johannes85/numitron-watch/README.md

Numitron Geekwatch
==============

See: http://www.domestichacks.info/projekte/numitron-geekwatch-armbanduhr/
