johannes85/numitron-watch/schematics/watch_main_schematics.png

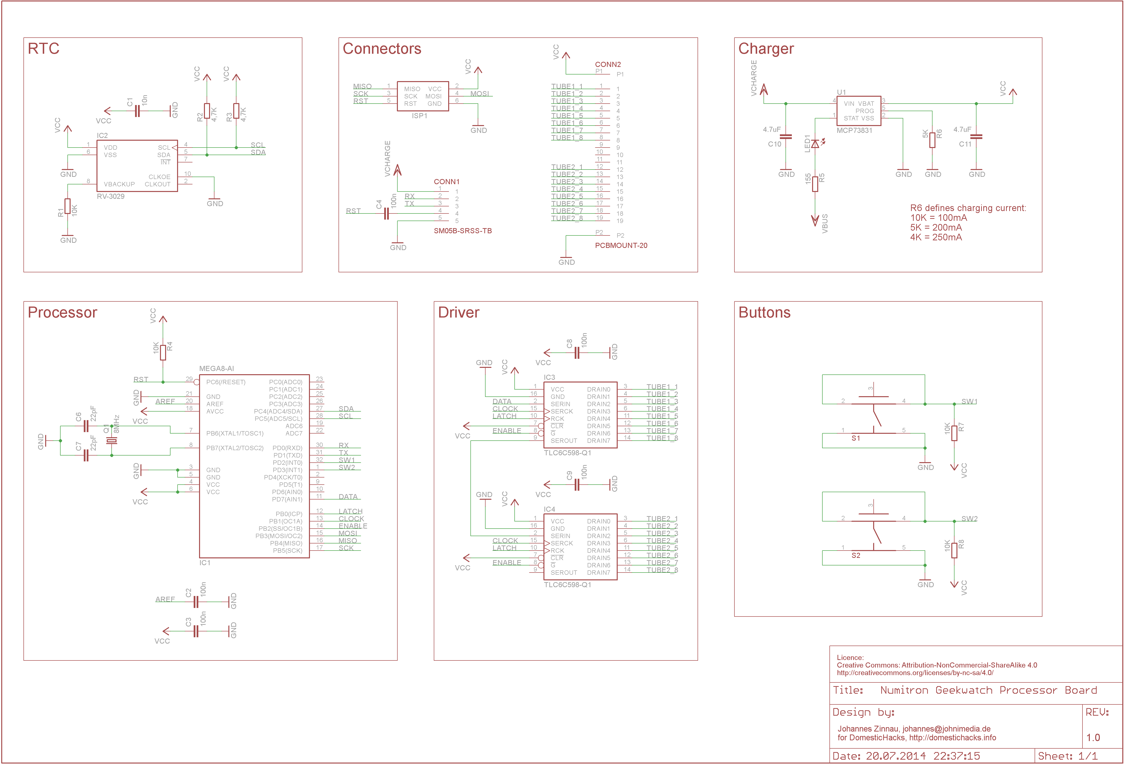
schematics/watch_main_schematics.png
