johannes85/numitron-watch/schematics/watch_tubes_schematics.png

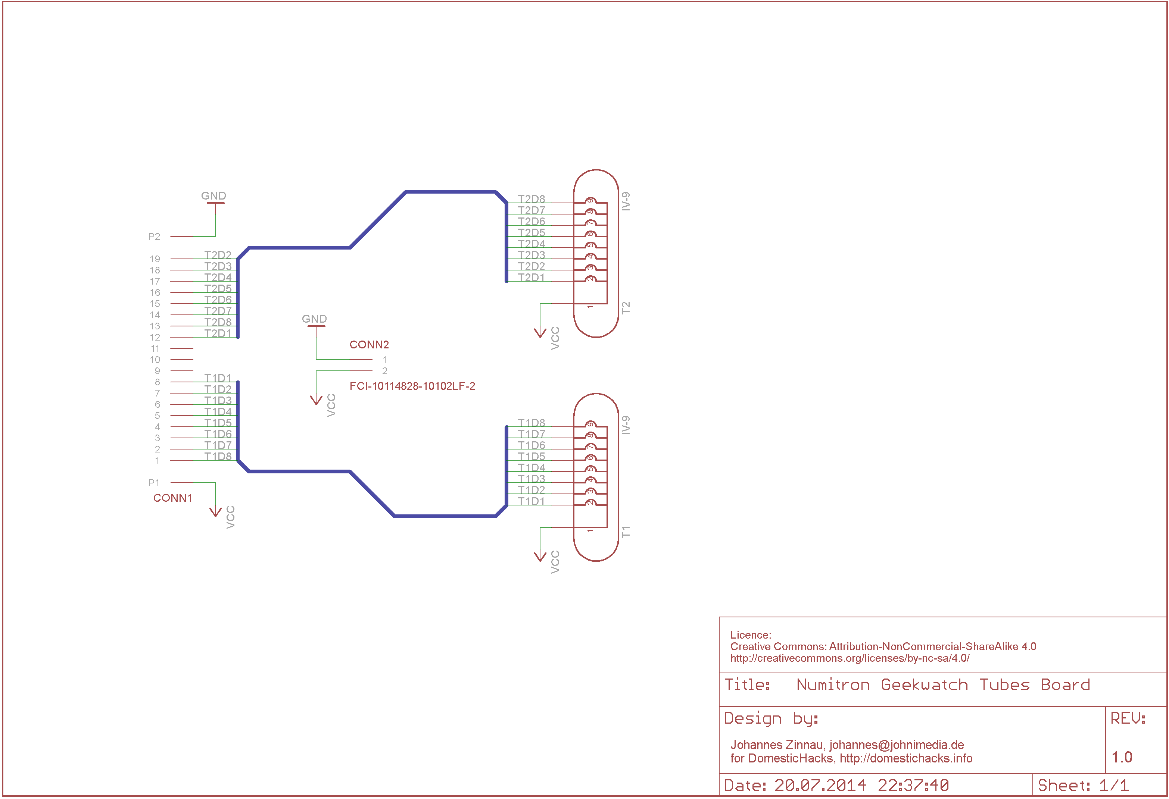
schematics/watch_tubes_schematics.png
