johannes85/numitron-watch/schematics/watch_tubes_final.brd

## EAGLE design schematics/watch_tubes_final.brd (2014-07-20)

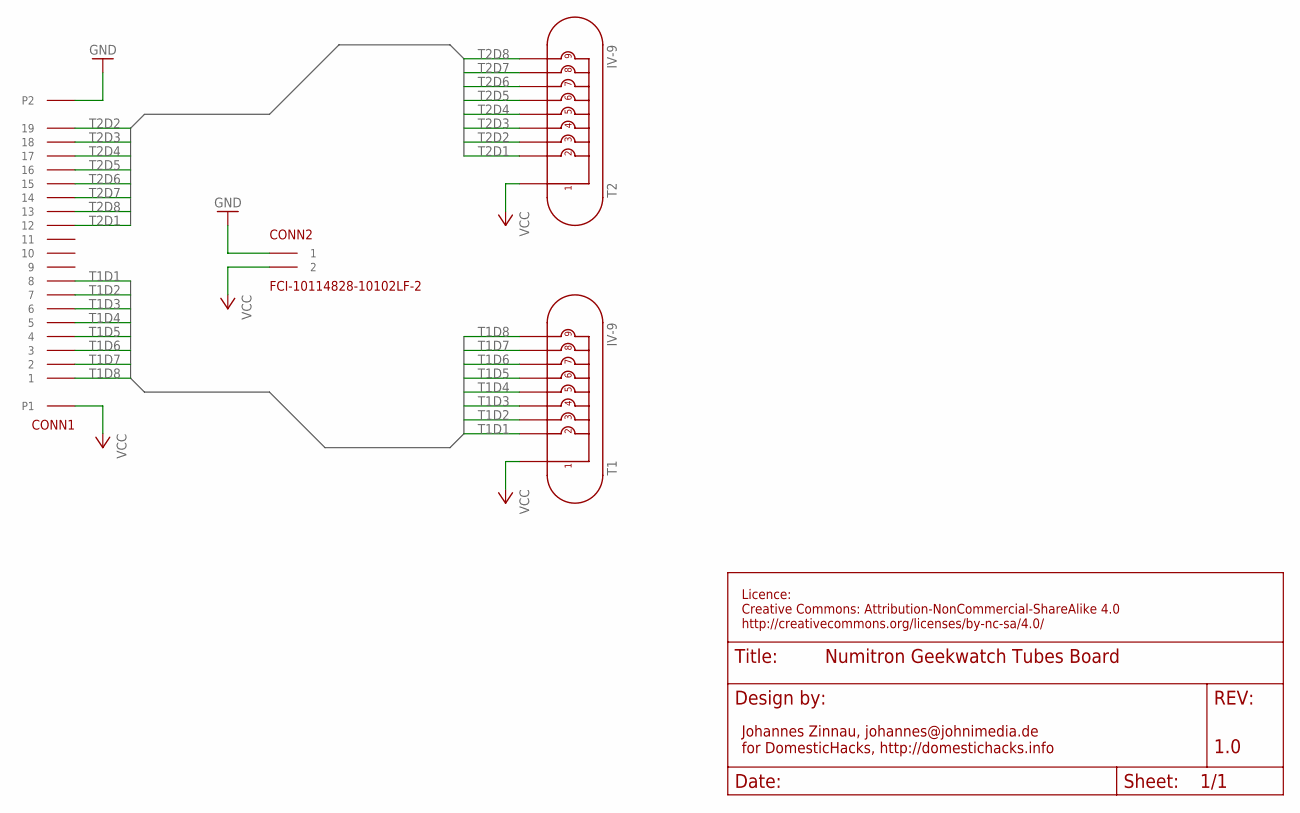
[picture p3: schematic watch_tubes_final.sch]

Parts:
CONN1: PCBMOUNT-20SECOND; PCBMOUNT-VERTICAL-20-2
CONN2: FCI-10114828-10102LF-2
T1, T2: IV-9

Connections:
GND: CONN1.P2, CONN2.1
T1D1: CONN1.8, T1.2
T1D2: CONN1.7, T1.3
T1D3: CONN1.6, T1.4
T1D4: CONN1.5, T1.5
T1D5: CONN1.4, T1.6
T1D6: CONN1.3, T1.7
T1D7: CONN1.2, T1.8
T1D8: CONN1.1, T1.9
T2D1: CONN1.12, T2.2
T2D2: CONN1.19, T2.3
T2D3: CONN1.18, T2.4
T2D4: CONN1.17, T2.5
T2D5: CONN1.16, T2.6
T2D6: CONN1.15, T2.7
T2D7: CONN1.14, T2.8
T2D8: CONN1.13, T2.9
VCC: CONN1.P1, CONN2.2, T1.1, T2.1

Notes on the sheet:
Licence: Creative Commons: Attribution-NonCommercial-ShareAlike 4.0 http://creativecommons.org/licenses/by-nc-sa/4.0/
Johannes Zinnau, johannes@johnimedia.de for DomesticHacks, http://domestichacks.info
1.0

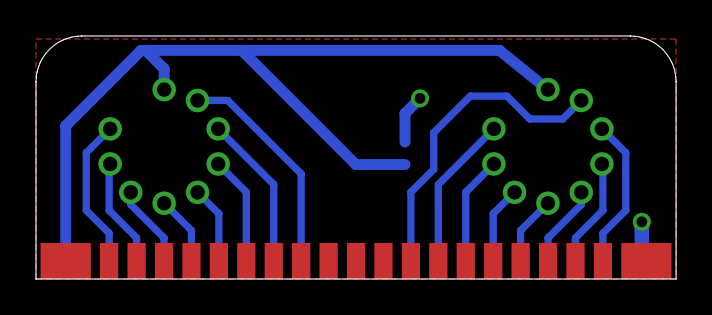
[picture p4: board watch_tubes_final.brd from above]

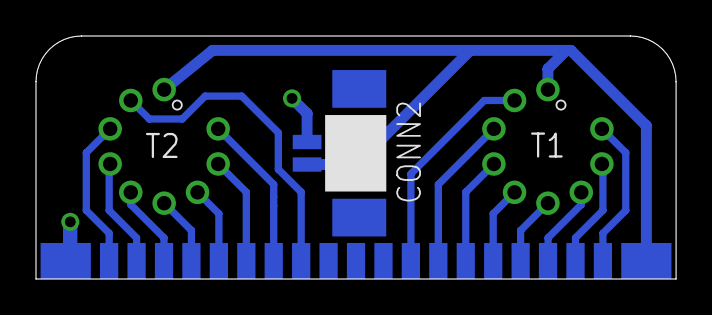
[picture p5: board watch_tubes_final.brd from below]

Board: 2 copper layers, 35.6 x 13.5 mm, 4 parts (4 on the bottom side), 18 nets.
