johannes85/numitron-watch/schematics/watch_main_final.brd

## EAGLE design schematics/watch_main_final.brd (2014-07-20)

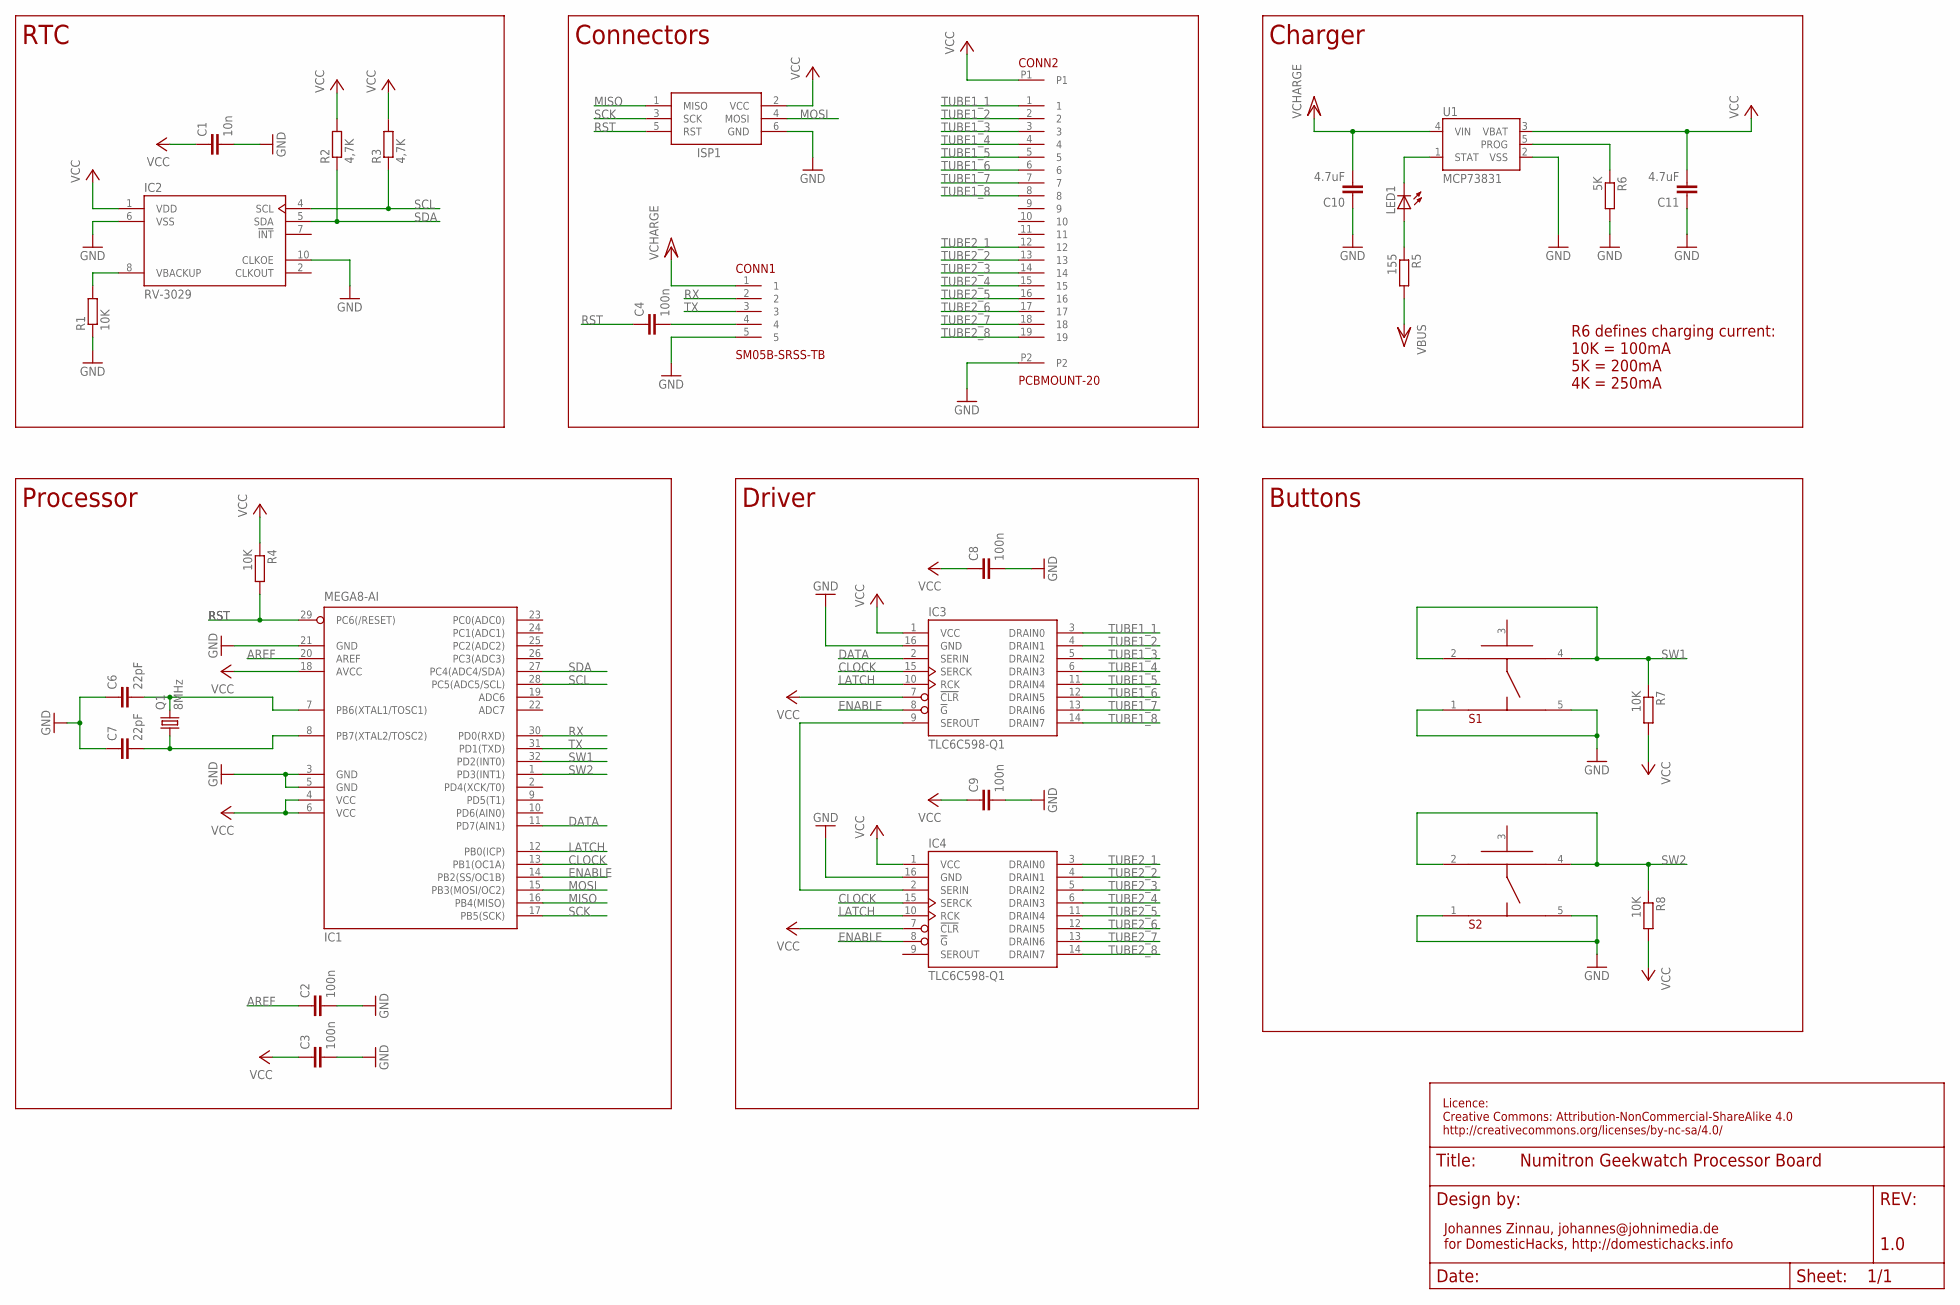
[picture p6: schematic watch_main_final.sch]

Parts:
C1: 10n; C0603
C2, C3, C4, C8, C9: 100n; C0603
C6, C7: 22pF; C0603
C10, C11: 4.7uF; C0603
CONN1: SM05B-SRSS-TB; JST-SR-SIDE-5
CONN2: PCBMOUNT-20; PCBMOUNT-VERTICAL-20
IC1: MEGA8-AI; TQFP32-08
IC2: RV-3029; RV-3029-C2
IC3, IC4: TLC6C598-Q1; TSSOP-16
ISP1: AVRISP-6; AVRISP
LED1: HSMA/C/L-C120FLIPPED; LED-0603-SIDE-FLIPPED
Q1: 8MHz; MQ
R1, R4, R7, R8: 10K; R0603
R2, R3: 4,7K; R0603
R5: 155; R0603
R6: 5K; R0603
S1, S2: KMSXXXG; C&K-KMS-SWITCH
U1: MCP73831; SOT23-5

Connections:
AREF: C2.1, IC1.20 (AREF)
CLOCK: IC1.13 (PB1(OC1A)), IC3.15 (SERCK), IC4.15 (SERCK)
DATA: IC1.11 (PD7(AIN1)), IC3.2 (SERIN)
ENABLE: IC1.14 (PB2(SS/OC1B)), IC3.8 (!G), IC4.8 (!G)
GND: C1.2, C2.2, C3.2, C6.1, C7.1, C8.2, C9.2, C10.1, C11.1, CONN1.5, CONN2.P2, IC1.3 (GND), IC1.5 (GND), IC1.21 (GND), IC2.6 (VSS), IC2.10 (CLKOE), IC3.16 (GND), IC4.16 (GND), ISP1.6 (GND), R1.1, R6.2, S1.1, S1.5, S2.1, S2.5, U1.2 (VSS)
LATCH: IC1.12 (PB0(ICP)), IC3.10 (RCK), IC4.10 (RCK)
MISO: IC1.16 (PB4(MISO)), ISP1.1 (MISO)
MOSI: IC1.15 (PB3(MOSI/OC2)), ISP1.4 (MOSI)
unnamed: IC2.8 (VBACKUP), R1.2
unnamed: IC3.9 (SEROUT), IC4.2 (SERIN)
unnamed: C6.2, IC1.7 (PB6(XTAL1/TOSC1)), Q1.P3 (2)
unnamed: C7.2, IC1.8 (PB7(XTAL2/TOSC2)), Q1.P1 (1)
unnamed: LED1.C, U1.1 (STAT)
unnamed: LED1.A, R5.1
unnamed: R6.1, U1.5 (PROG)
unnamed: C4.2, CONN1.4
RST: C4.1, IC1.29 (PC6(/RESET)), ISP1.5 (RST), R4.2
RX: CONN1.2, IC1.30 (PD0(RXD))
SCK: IC1.17 (PB5(SCK)), ISP1.3 (SCK)
SCL: IC1.28 (PC5(ADC5/SCL)), IC2.4 (SCL), R3.1
SDA: IC1.27 (PC4(ADC4/SDA)), IC2.5 (SDA), R2.1
SW1: IC1.32 (PD2(INT0)), R7.1, S1.2, S1.4
SW2: IC1.1 (PD3(INT1)), R8.1, S2.2, S2.4
TUBE1_1: CONN2.1, IC3.3 (DRAIN0)
TUBE1_2: CONN2.2, IC3.4 (DRAIN1)
TUBE1_3: CONN2.3, IC3.5 (DRAIN2)
TUBE1_4: CONN2.4, IC3.6 (DRAIN3)
TUBE1_5: CONN2.5, IC3.11 (DRAIN4)
TUBE1_6: CONN2.6, IC3.12 (DRAIN5)
TUBE1_7: CONN2.7, IC3.13 (DRAIN6)
TUBE1_8: CONN2.8, IC3.14 (DRAIN7)
TUBE2_1: CONN2.12, IC4.3 (DRAIN0)
TUBE2_2: CONN2.13, IC4.4 (DRAIN1)
TUBE2_3: CONN2.14, IC4.5 (DRAIN2)
TUBE2_4: CONN2.15, IC4.6 (DRAIN3)
TUBE2_5: CONN2.16, IC4.11 (DRAIN4)
TUBE2_6: CONN2.17, IC4.12 (DRAIN5)
TUBE2_7: CONN2.18, IC4.13 (DRAIN6)
TUBE2_8: CONN2.19, IC4.14 (DRAIN7)
TX: CONN1.3, IC1.31 (PD1(TXD))
VCC: C1.1, C3.1, C8.1, C9.1, C11.2, CONN2.P1, IC1.4 (VCC), IC1.6 (VCC), IC1.18 (AVCC), IC2.1 (VDD), IC3.1 (VCC), IC3.7 (!CLR), IC4.1 (VCC), IC4.7 (!CLR), ISP1.2 (VCC), R2.2, R3.2, R4.1, R7.2, R8.2, U1.3 (VBAT)
VCC/2: C10.2, CONN1.1, R5.2, U1.4 (VIN)

Notes on the sheet:
RTC
Processor
Driver
Connectors
R6 defines charging current: 10K = 100mA 5K = 200mA 4K = 250mA
Charger
Buttons
Licence: Creative Commons: Attribution-NonCommercial-ShareAlike 4.0 http://creativecommons.org/licenses/by-nc-sa/4.0/
Johannes Zinnau, johannes@johnimedia.de for DomesticHacks, http://domestichacks.info
1.0

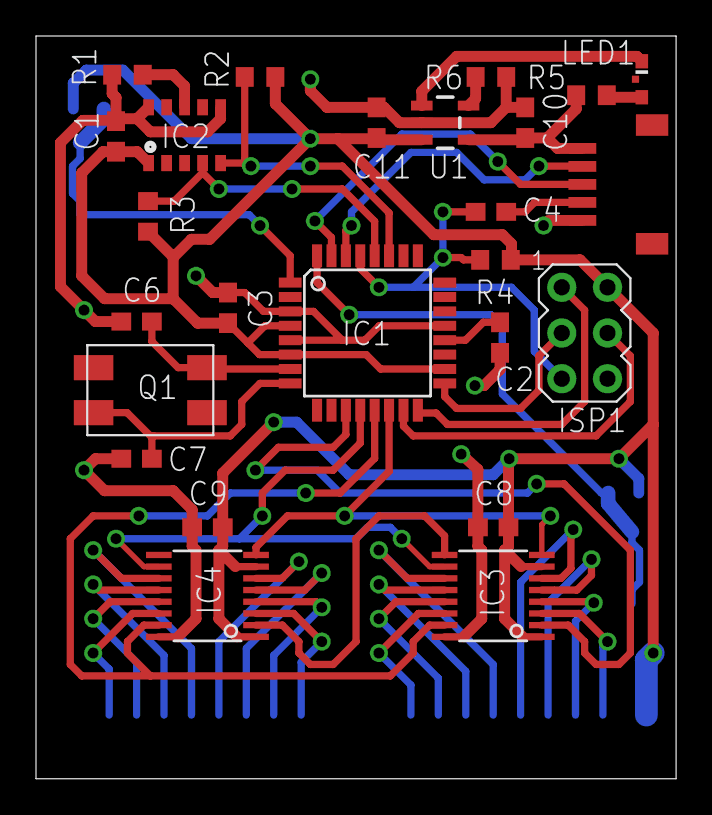
[picture p7: board watch_main_final.brd from above]

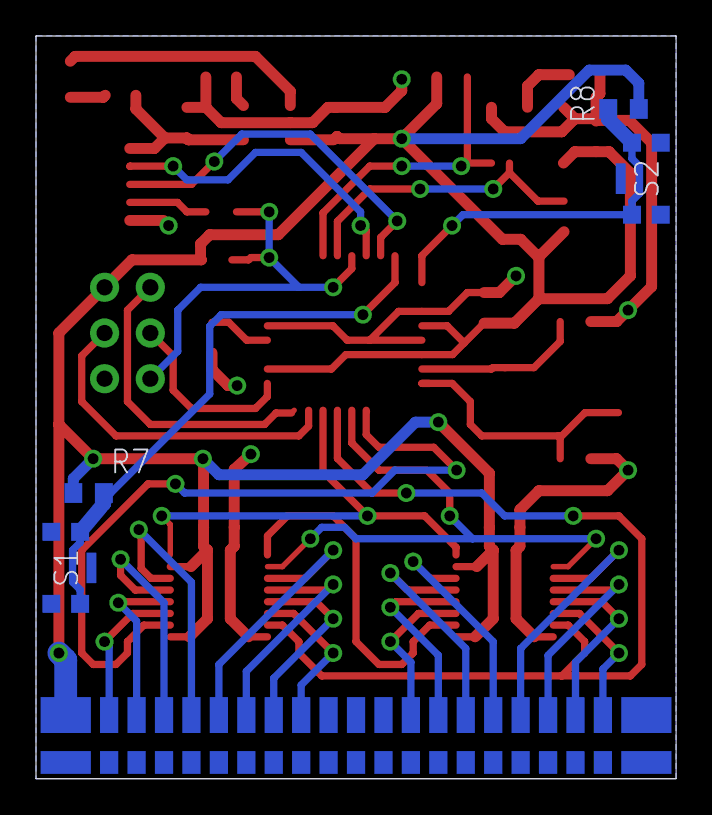
[picture p8: board watch_main_final.brd from below]

Board: 2 copper layers, 35.6 x 41.3 mm, 30 parts (5 on the bottom side), 42 nets.
